ylinJiang/Maze-Breaker/README.md

# Maze-Breaker
Designed and implemented a 3D-printed robot capable of mapping and solving mazes in two phases: sensor-based exploration (left-hand rule) and optimized pathfinding for speed.

## Here is our design.
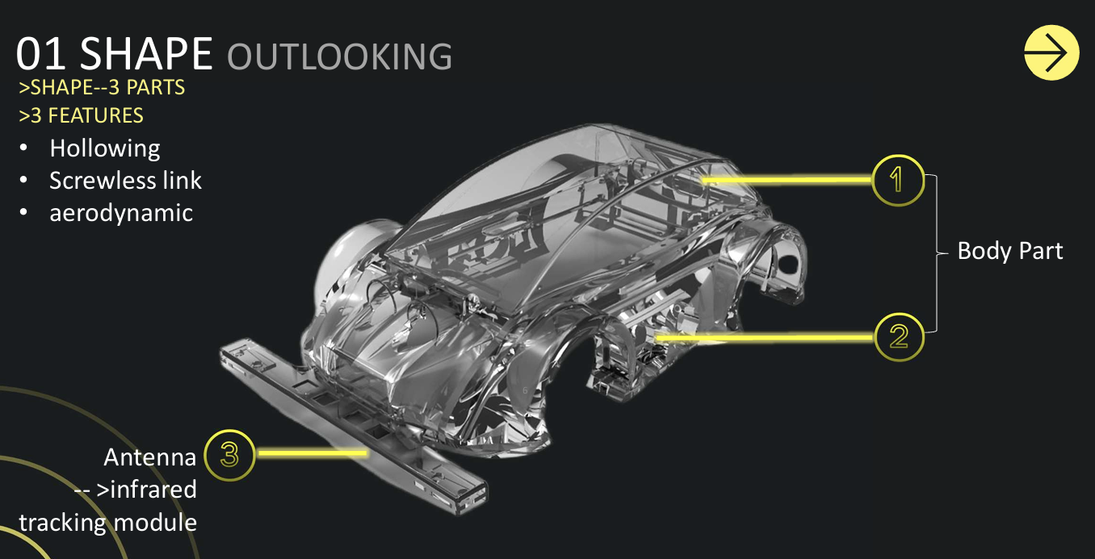
[picture p1: Designed Car.png]
