ylinJiang/Maze-Breaker/Final PPT.pdf

# MAZE-BREAKER Group member 敖恺

- 江柯垚
- 解炎
- 姜跃琳
- 张善
（排名不分先后）

2

2

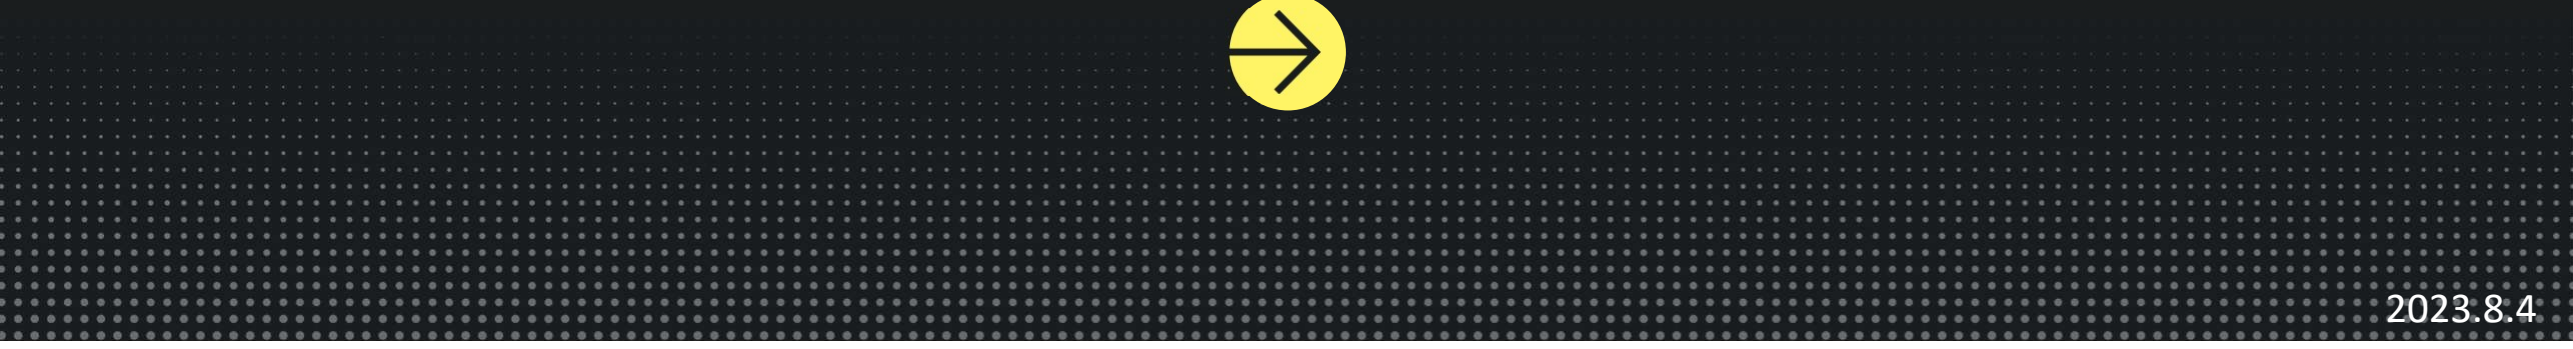
[picture p27: figure]

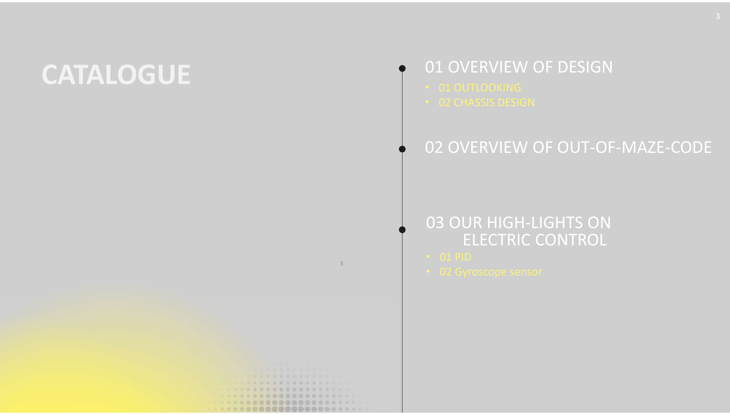
[picture p28: figure]
01 OVERVIEW OF DESIGN; • 01 OUTLOOKING • 02 CHASSIS DESIGN; 02 OVERVIEW OF OUT-OF-MAZE-CODE; 03 OUR HIGH-LIGHTS ON ELECTRIC CONTROL • 01 PID • 02 Gyroscope sensor; CATALOGUE

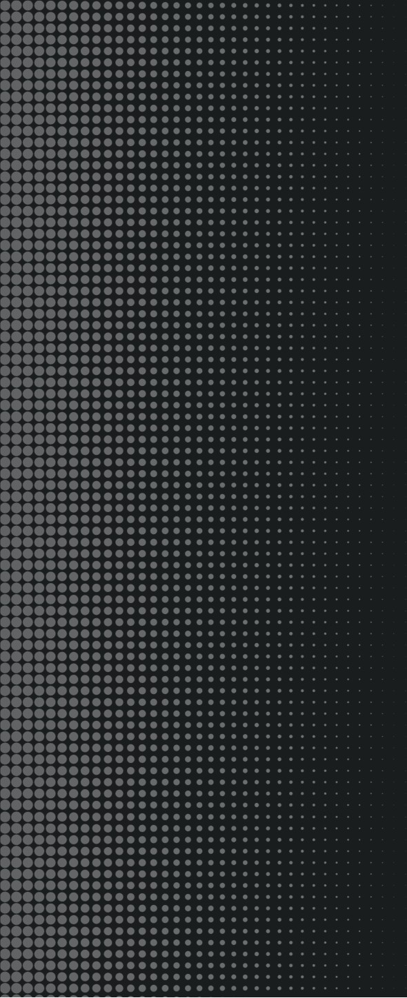
[picture p29: figure]

# 01 OVERVIEW OF DESIGN

### 01 OUTLOOKING

4

4

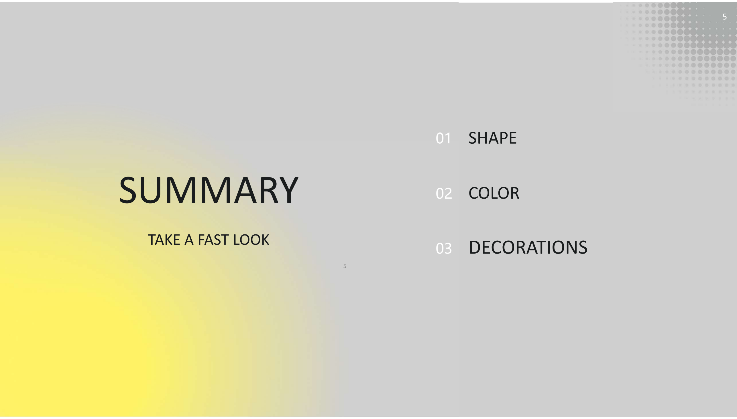
[picture p30: page 4]

# SUMMARY

TAKE A FAST LOOK

### 01 SHAPE

### 02 COLOR

### 03 DECORATIONS

5

5

## 01 SHAPE OUTLOOKING

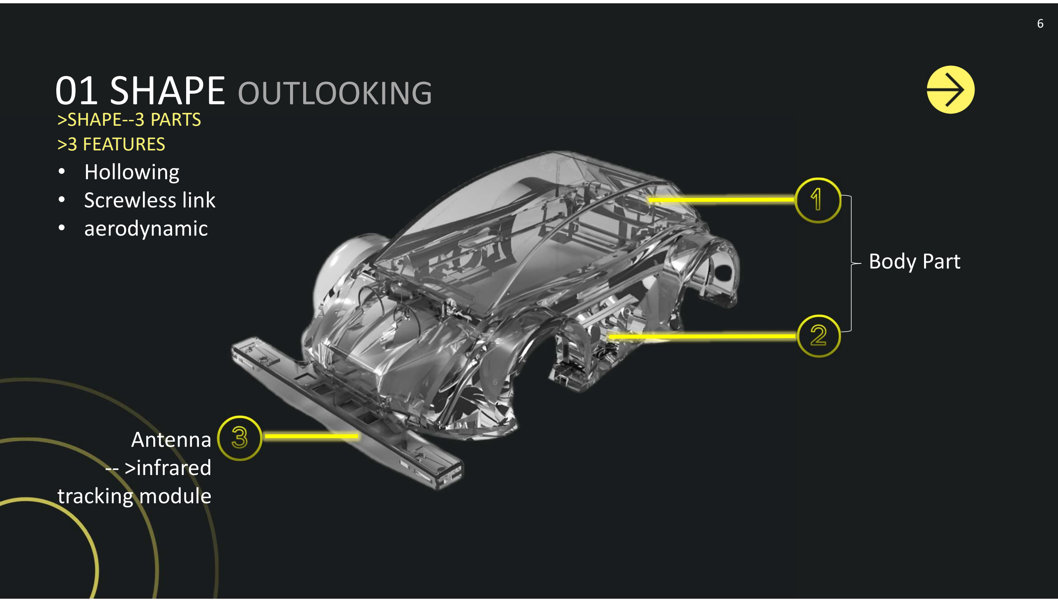
[picture p31: page 5]

>SHAPE--3 PARTS
>3 FEATURES

Body Part

Antenna
-- >infrared
tracking module
- Hollowing
- Screwless link
- aerodynamic

6

6

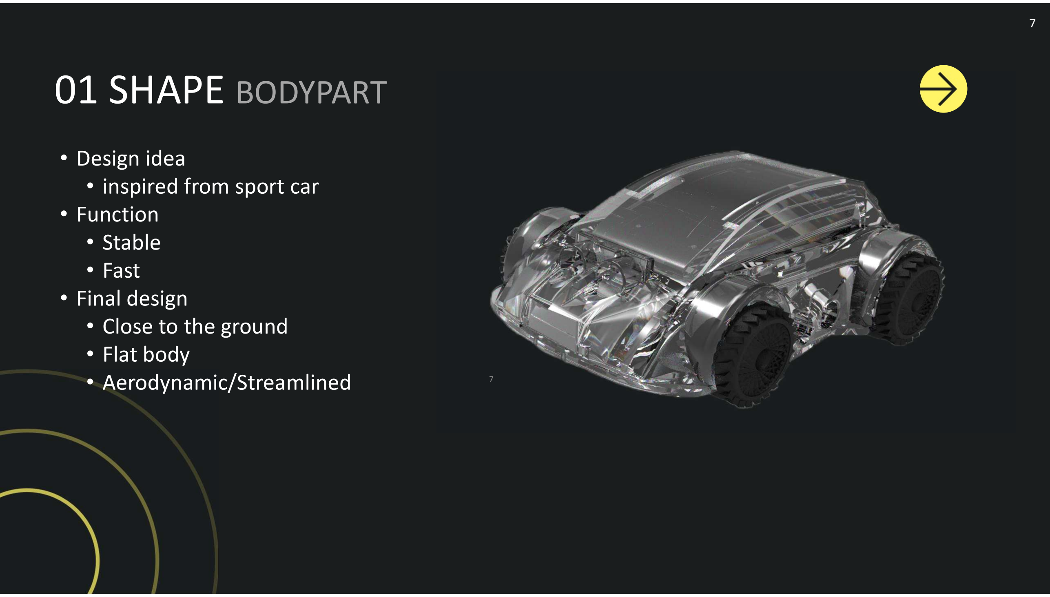
[picture p32: page 6]

01 SHAPE BODYPART • Design idea • inspired from sport car • Function • Stable • Fast • Final design • Close to the ground • Flat body • Aerodynamic/Streamlined | 7 | 7

# 01 SHAPE Antenna

- Function
- Protect the infrared tracking module
- Expand the scope of exploration

8

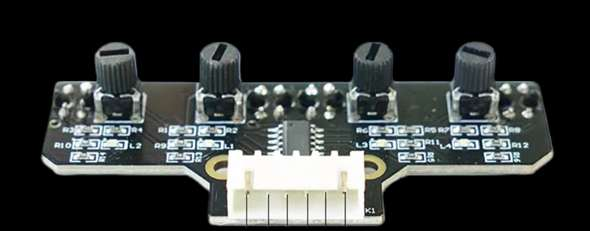
[picture p33: figure]
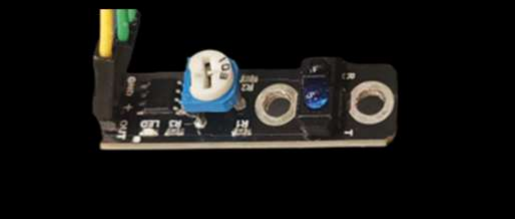
[picture p34: figure]
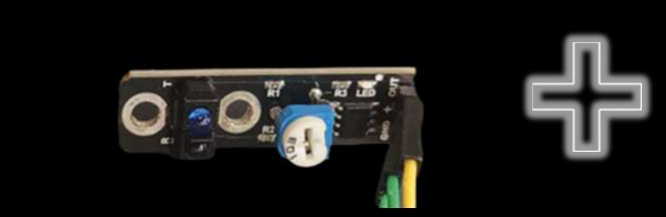
[picture p35: figure]
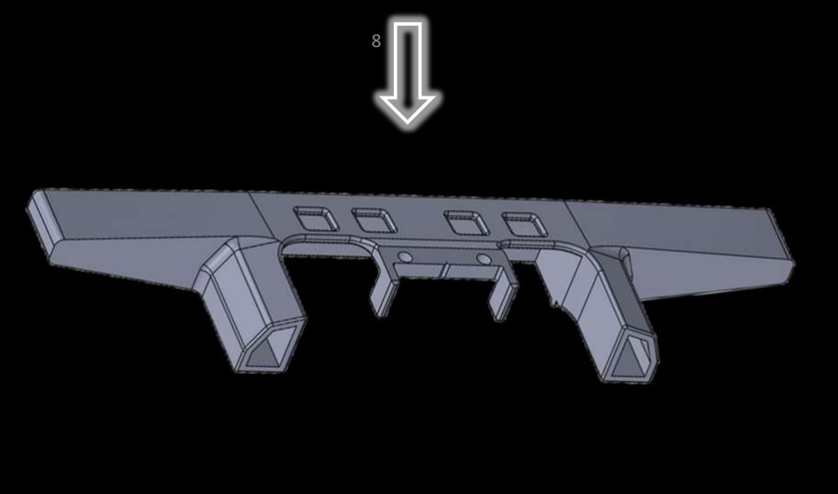
[picture p36: figure]
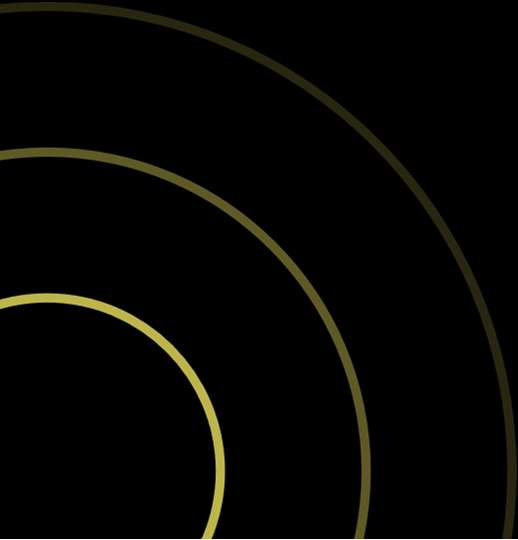
[picture p37: figure]

# 02 COLOR

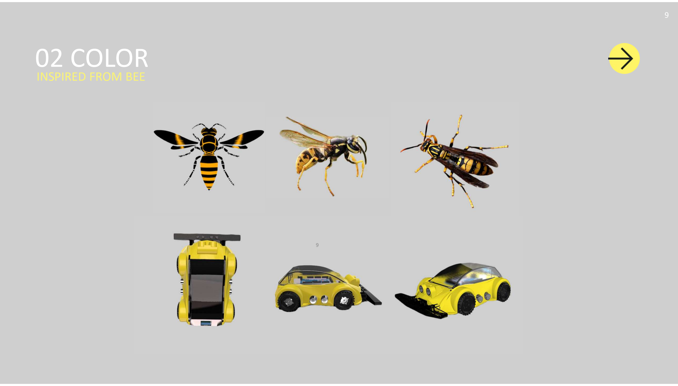
[picture p38: page 8]

INSPIRED FROM BEE

9

9

# 02 DECORATIONS

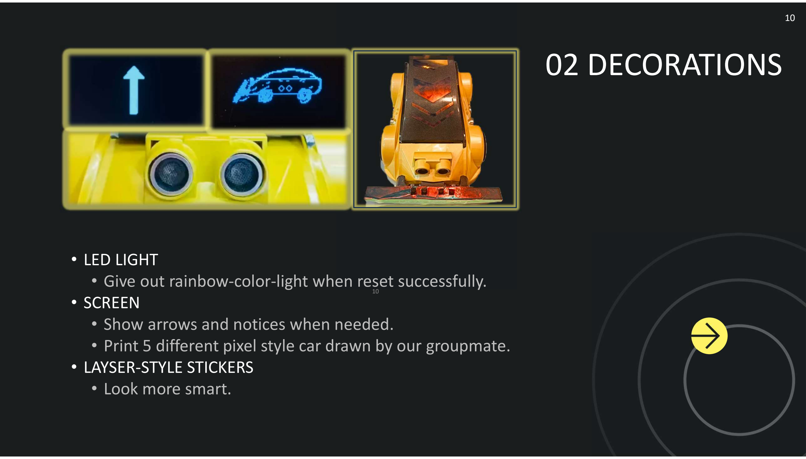
[picture p39: page 9]

- LED LIGHT
- Give out rainbow-color-light when reset successfully.
- SCREEN
- Show arrows and notices when needed.
- Print 5 different pixel style car drawn by our groupmate.
- LAYSER-STYLE STICKERS
- Look more smart.

10

10

# OVER VEIW OF THE WHOLE PRODUCT

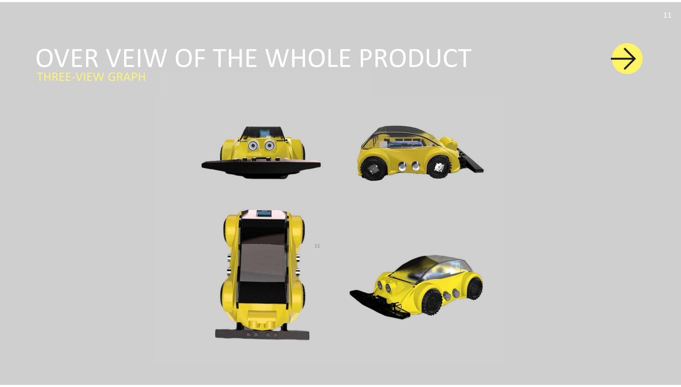
[picture p40: page 10]

THREE-VIEW GRAPH

11

11

# OVER VEIW OF THE WHOLE PRODUCT

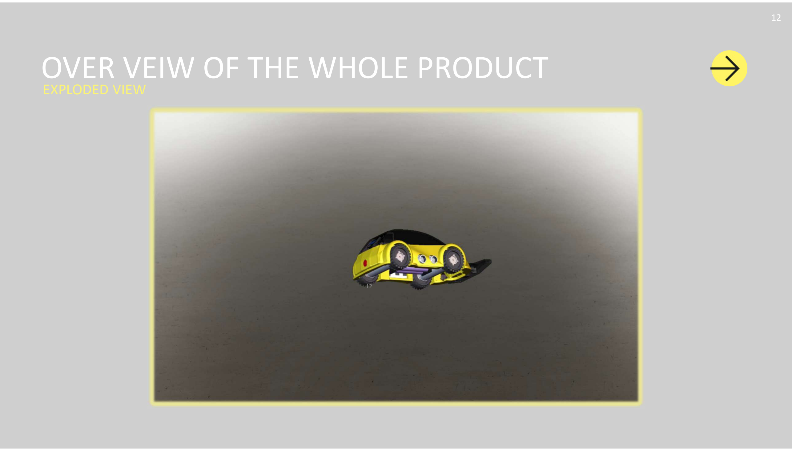
[picture p41: page 11]

EXPLODED VIEW

12

12

# 01 OVERVIEW OF DESIGN

### 02 CHASSIS DESIGN

13

13

# 1 CHASSIS DESIGN

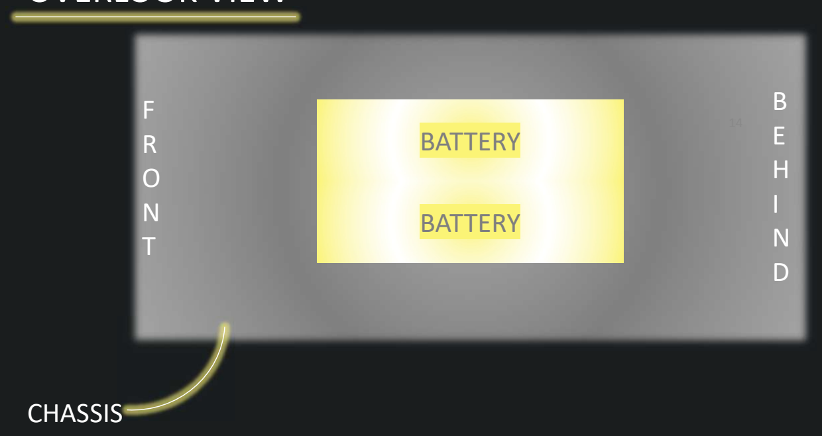
[picture p42: figure]
FRONT; BATTERY; CHASSIS

CHASSIS

SIDE VIEW

OVERLOOK VIEW

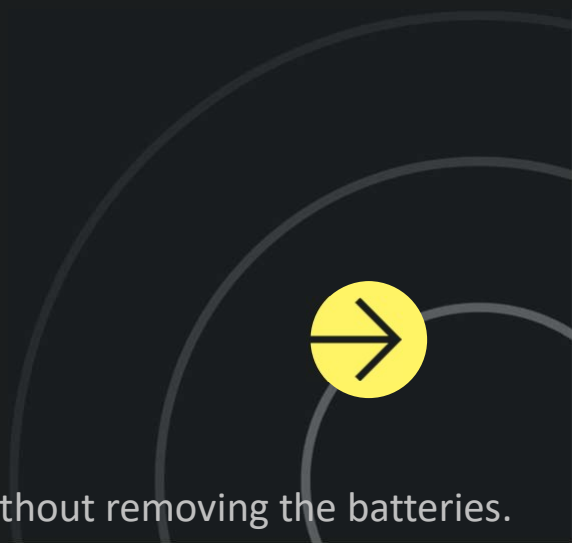
[picture p43: figure]

- The long-side of battery case parallel to the long-side of car --More space left for the
equipment of ultrasonic.
- Leave type-C joggle* on the batter case behind
--Wires connect easier.

type-C joggle*:Used to charge the battery without removing the batteries.

14

# CHASSIS DESIGN

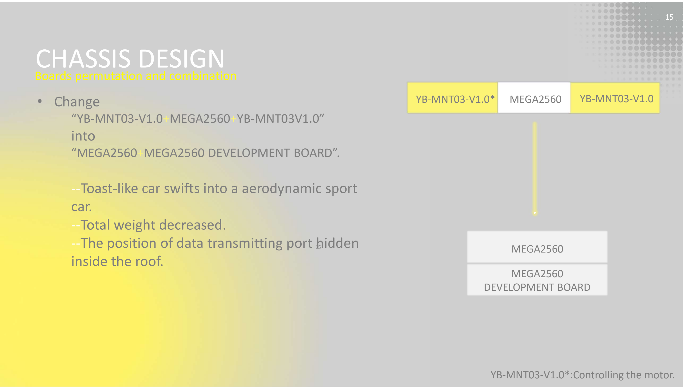
[picture p44: page 14]

- Change
“YB-MNT03-V1.0+MEGA2560+YB-MNT03V1.0” into
“MEGA2560+MEGA2560 DEVELOPMENT BOARD”. --Toast-like car swifts into a aerodynamic sport

car. --Total weight decreased. --The position of data transmitting port hidden

inside the roof.

YB-MNT03-V1.0* MEGA2560 YB-MNT03-V1.0

MEGA2560

MEGA2560
DEVELOPMENT BOARD

YB-MNT03-V1.0*:Controlling the motor.

Boards permutation and combination

15

15

# CHASSIS DESIGN

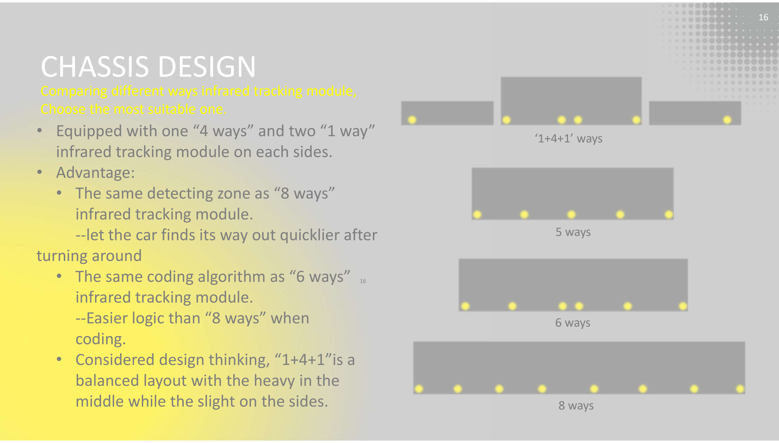
[picture p45: page 15]

- Equipped with one “4 ways” and two “1 way” infrared tracking module on each sides. • Advantage: • The same detecting zone as “8 ways”

infrared tracking module.
--let the car finds its way out quicklier after turning around • The same coding algorithm as “6 ways”

infrared tracking module.
--Easier logic than “8 ways” when
coding. • Considered design thinking, “1+4+1”is a

balanced layout with the heavy in the middle while the slight on the sides.

Comparing different ways infrared tracking module, Choose the most suitable one.

‘1+4+1’ ways

### 5 ways

### 6 ways

### 8 ways

16

16

# OVERVIEW OF OUT-OF-MAZE-CODE

17

17

# OVERAL IDEAS

### 1 EXPLORE THE WAY OUT

Abstract the zero-one-matrix from the trail.

### 2 REMAP THE ZERO-ONE-MATRIX

Delete dead ends.

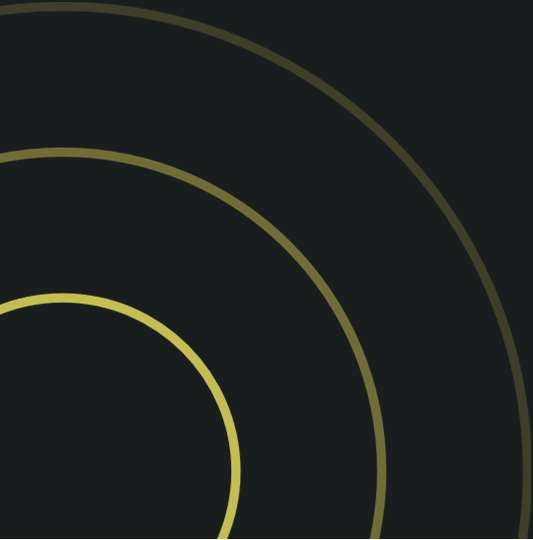
[picture p46: figure]

### 3 GET CORNER’S COORDINATE

Select corner by traversal.

### 4 WALK OUT WITHOUT DEAD ENDS

Use selected corners when needed.

18

18

# 1 EXPLORE THE WAY OUT

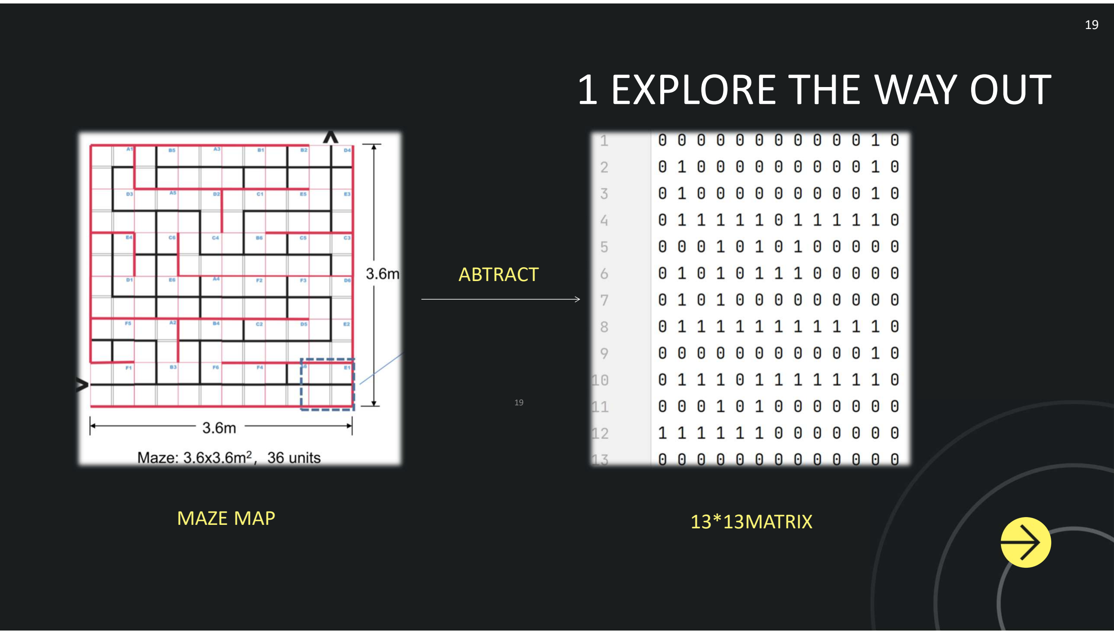
[picture p47: page 18]

ABTRACT

MAZE MAP | 13*13MATRIX

19

19

# 2 REMAP THE ZERO-ONE-MATRIX

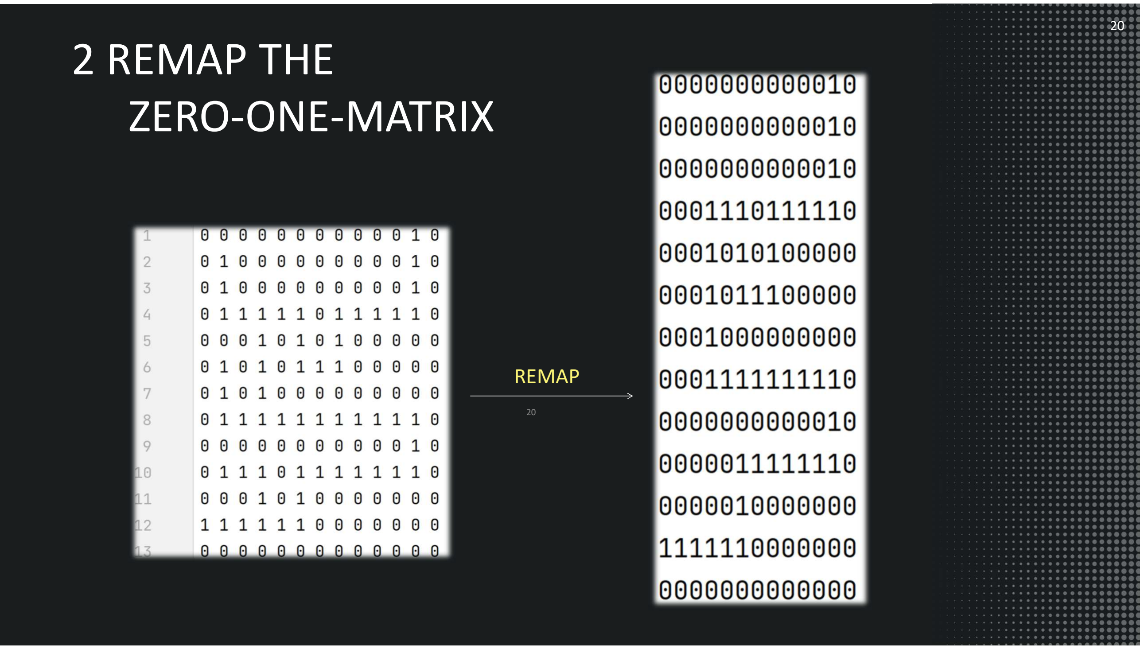
[picture p48: page 19]

REMAP

20

20

# 03 GET CORNER’S COORDINATE

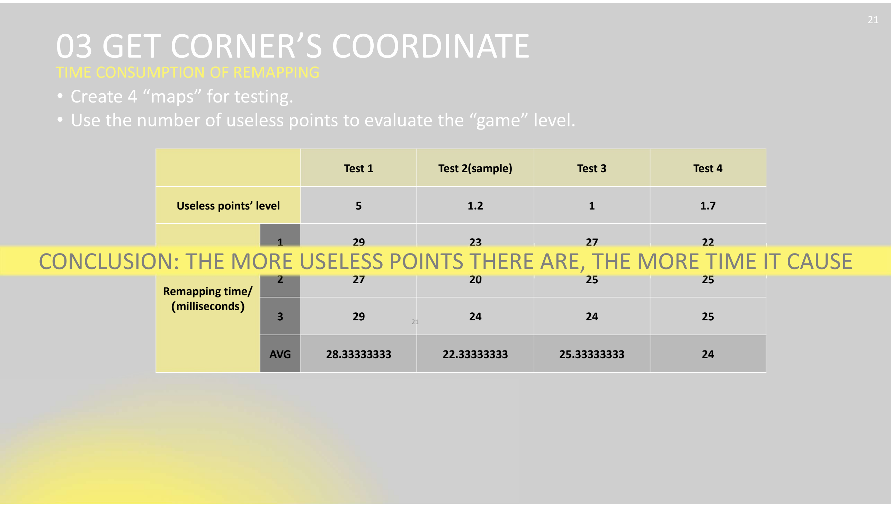
[picture p49: page 20]

TIME CONSUMPTION OF REMAPPING

| Test 1 | Test 2(sample) | Test 3 | Test 4
Useless points’ level | 5 | 1.2 | 1 | 1.7
Remapping time/ （milliseconds） | 1 | 29 | 23 | 27 | 22
| 2 | 27 | 20 | 25 | 25
| 3 | 29 21 | 24 | 24 | 25
| AVG | 28.33333333 | 22.33333333 | 25.33333333 | 24
- Create 4 “maps” for testing.
- Use the number of useless points to evaluate the “game” level.

### CONCLUSION: THE MORE USELESS POINTS THERE ARE, THE MORE TIME IT CAUSE

TIME CONSUMPTION OF REMAPPING

21

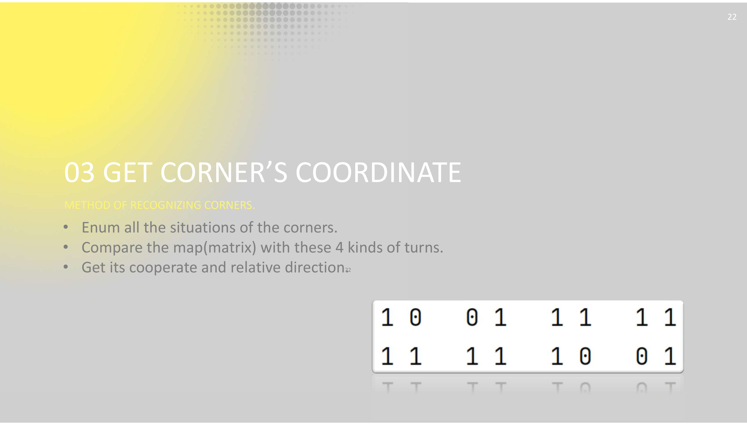
[picture p50: page 21]

METHOD OF RECOGNIZING CORNERS.

# 03 GET CORNER’S COORDINATE

- Enum all the situations of the corners.
- Compare the map(matrix) with these 4 kinds of turns.
- Get its cooperate and relative direction.22

22

# 03 GET CORNER’S COORDINATE

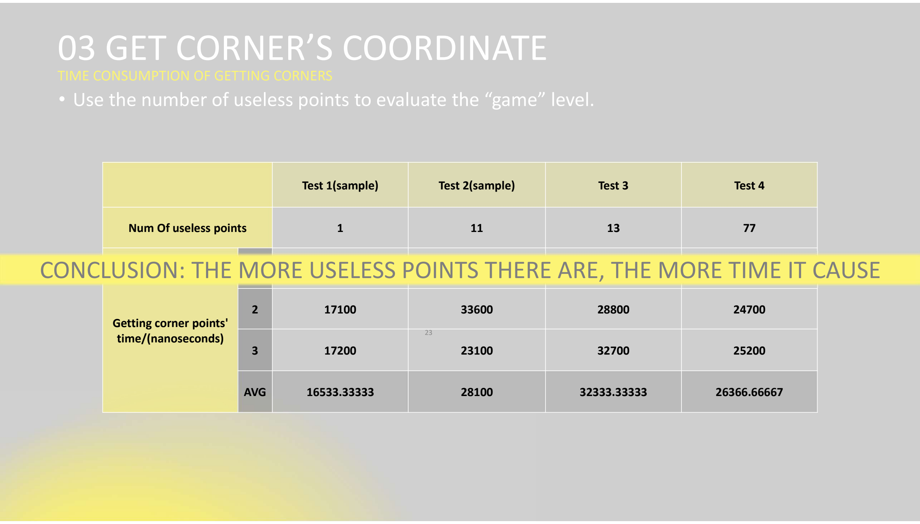
[picture p51: page 22]

| Test 1(sample) | Test 2(sample) | Test 3 | Test 4
Num Of useless points | 1 | 11 | 13 | 77
Getting corner points' time/(nanoseconds) | 1 | 15300 | 27600 | 35500 | 29200
| 2 | 17100 | 33600 | 28800 | 24700
| 3 | 17200 | 23 23100 | 32700 | 25200
| AVG | 16533.33333 | 28100 | 32333.33333 | 26366.66667

TIME CONSUMPTION OF GETTING CORNERS

### CONCLUSION: THE MORE USELESS POINTS THERE ARE, THE MORE TIME IT CAUSE

- Use the number of useless points to evaluate the “game” level.

# 03 WALK OUT WITHOUT DEAD ENDS

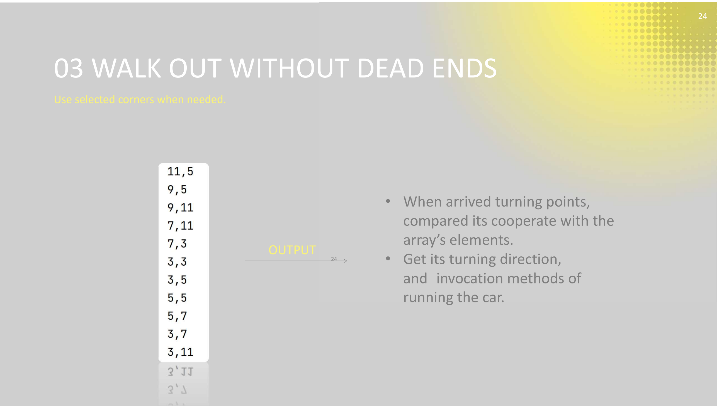
[picture p52: page 23]

Use selected corners when needed.

OUTPUT

- When arrived turning points, compared its cooperate with the array’s elements.
- Get its turning direction,
and invocation methods of
running the car.

24

24

# 03 OUR HIGH-LIGHTS ON

# Electric control

### 01 PID

25

25

# INCREMENT PID

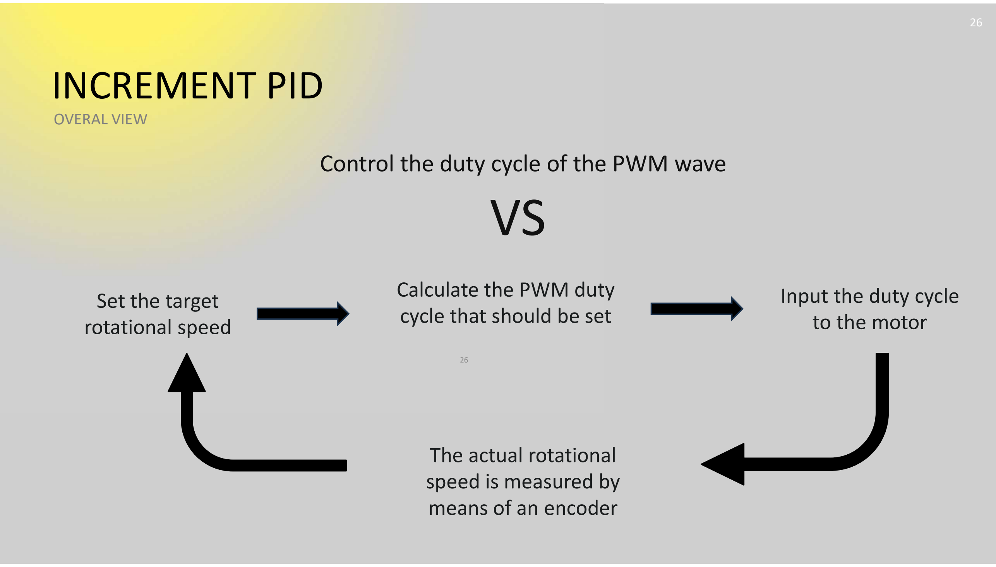
[picture p53: page 25]

Control the duty cycle of the PWM wave

The actual rotational
speed is measured by
means of an encoder

Calculate the PWM duty
cycle that should be set Set the target rotational speed

Input the duty cycle
to the motor

VS

OVERAL VIEW

26

26

# INCREMENT PID

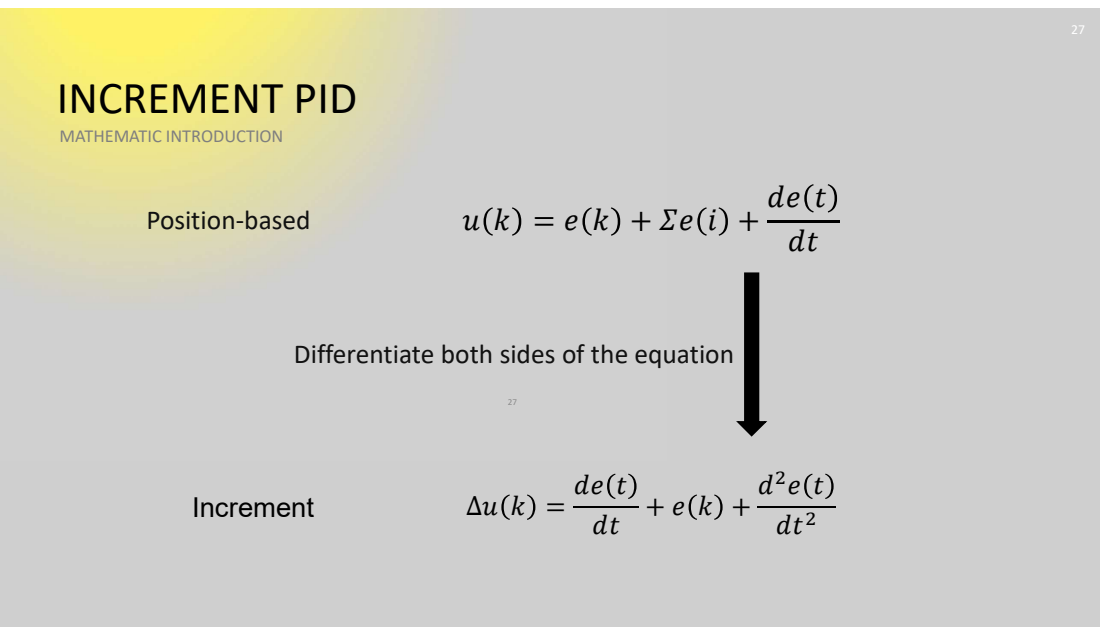
[picture p54: page 26]
Position-based; Increment; MATHEMATIC INTRODUCTION

Differentiate both sides of the equation

# INCREMENT PID

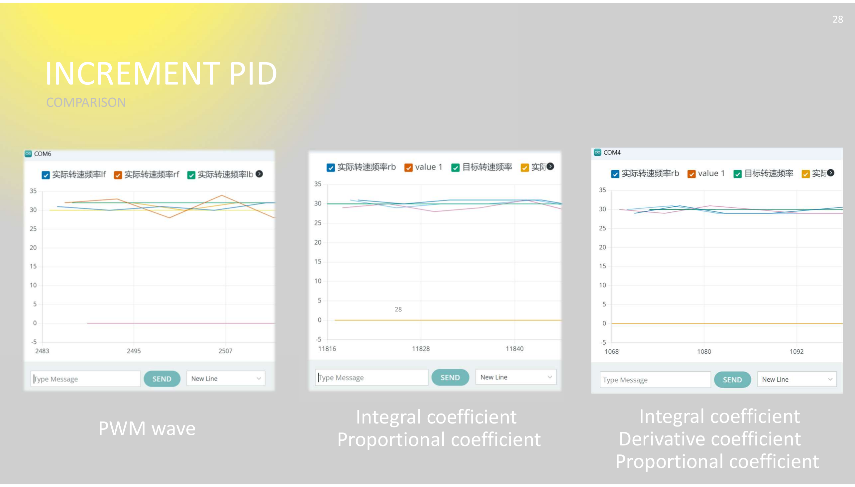
[picture p55: page 27]

COMPARISON

PWM wave | Integral coefficient Proportional coefficient

Integral coefficient
Derivative coefficient
Proportional coefficient

28

28

# INCREMENT PID

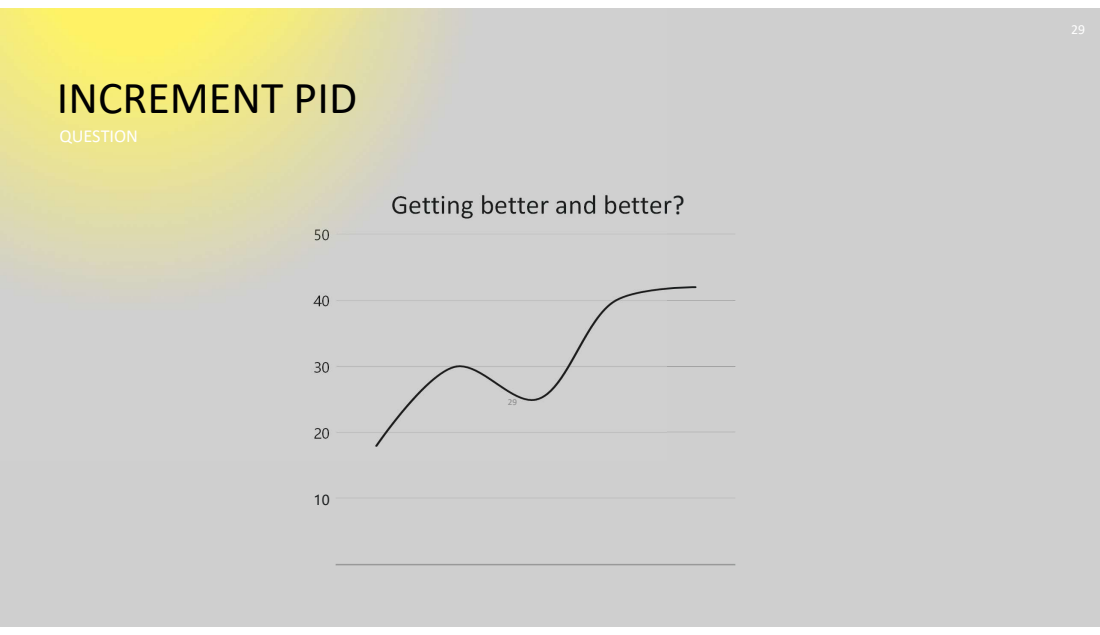
[picture p56: page 28]
QUESTION

Getting better and better?

# PID

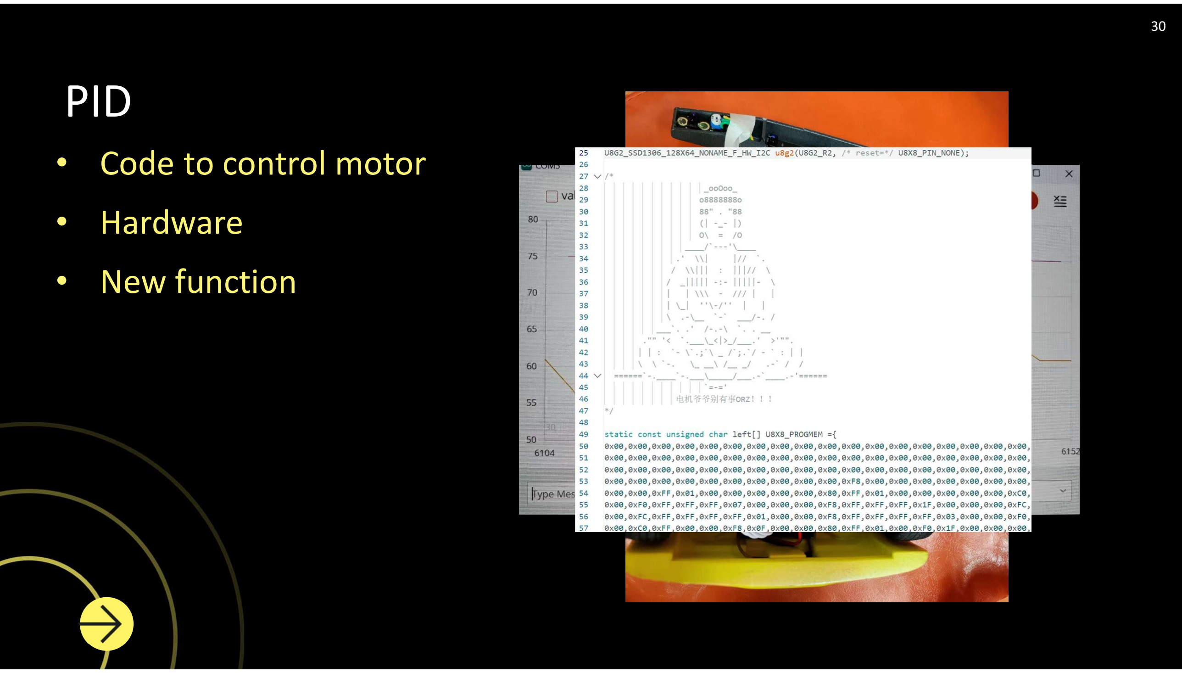
[picture p57: page 29]

## - Code to control motor - Hardware - New function

30

30

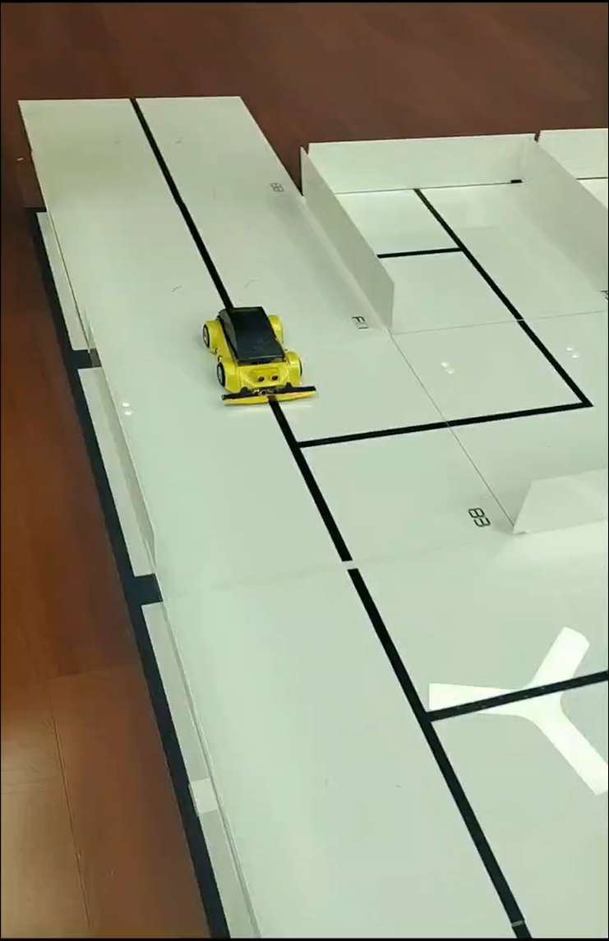
[picture p58: figure]

## - The infrared tracking module - Out –loop control

## - PID - Inner-loop control

# Electric control

31

31

# 03 OUR HIGH-LIGHTS ON

# Electric control

### 02 Gyroscope sensor MPU6050

32

32

# 03 GROSCOPE SENSOR MPU6050

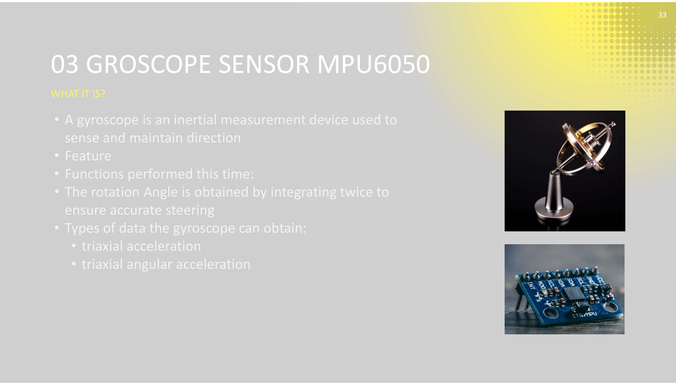
[picture p59: page 32]

WHAT IT IS?

33

- A gyroscope is an inertial measurement device used to sense and maintain direction
- Feature
- Functions performed this time:
- The rotation Angle is obtained by integrating twice to ensure accurate steering
- Types of data the gyroscope can obtain:
- triaxial acceleration
- triaxial angular acceleration

# 03 GROSCOPE SENSOR MPU6050

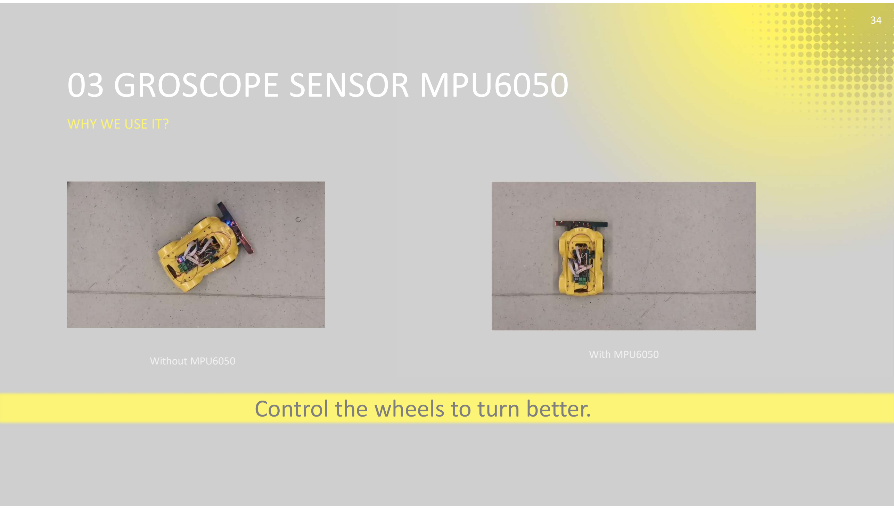
[picture p60: page 33]

WHY WE USE IT?

34

Control the wheels to turn better.

Without MPU6050 | With MPU6050

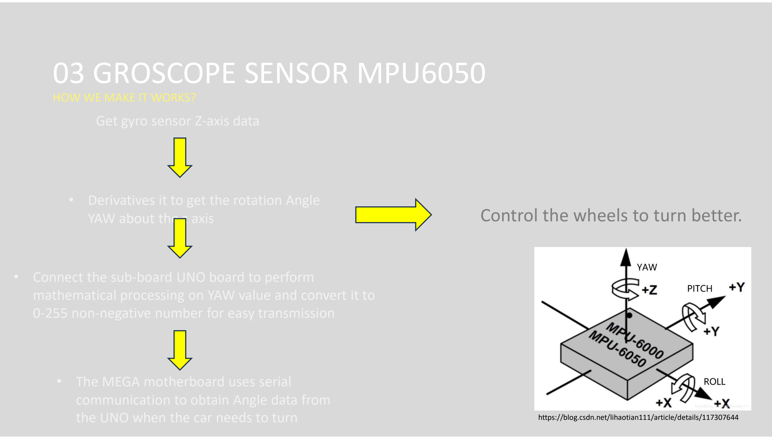
[picture p61: figure]
Get gyro sensor Z-axis data; https://blog.csdn.net/lihaotian111/article/details/117307644; YAW about the z axis; • The MEGA motherboard uses serial communication to obtain Angle data from the UNO when the car needs to turn; Control the wheels to turn better.; 03 GROSCOPE SENSOR MPU6050; HOW WE MAKE IT WORKS?

- Derivatives it to get the rotation Angle
- Connect the sub-board UNO board to perform mathematical processing on YAW value and convert it to 0-255 non-negative number for easy transmission

# 03 GROSCOPE SENSOR MPU6050

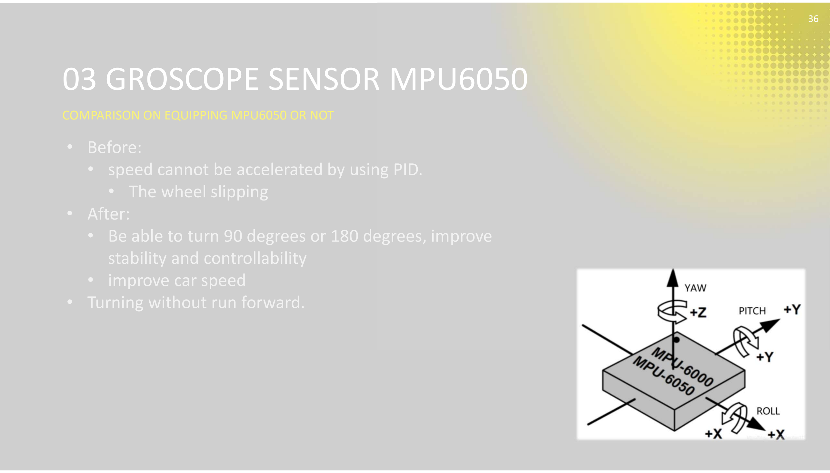
[picture p62: page 35]

COMPARISON ON EQUIPPING MPU6050 OR NOT

36

- Before:
- speed cannot be accelerated by using PID.
- The wheel slipping
- After:
- Be able to turn 90 degrees or 180 degrees, improve stability and controllability
- improve car speed
- Turning without run forward.

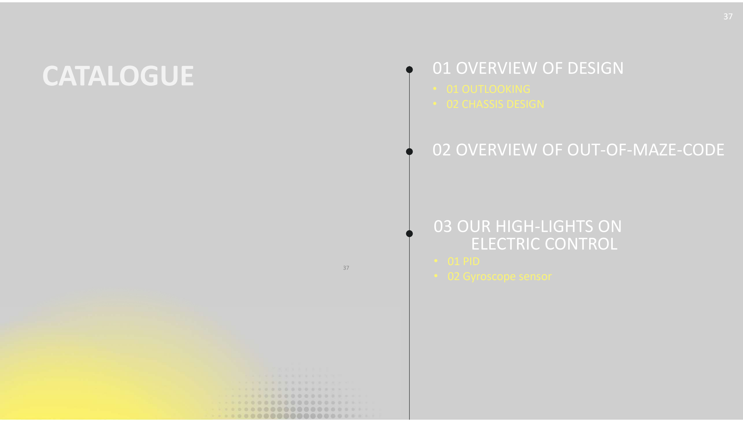
[picture p63: figure]
CATALOGUE; 01 OVERVIEW OF DESIGN; • 01 OUTLOOKING • 02 CHASSIS DESIGN; 02 OVERVIEW OF OUT-OF-MAZE-CODE; 03 OUR HIGH-LIGHTS ON ELECTRIC CONTROL • 01 PID • 02 Gyroscope sensor

# THANKS FOR LISTENING

38

38
