ylinJiang/Maze-Breaker/car_modeling_files/Part1_Cover.SLDPRT

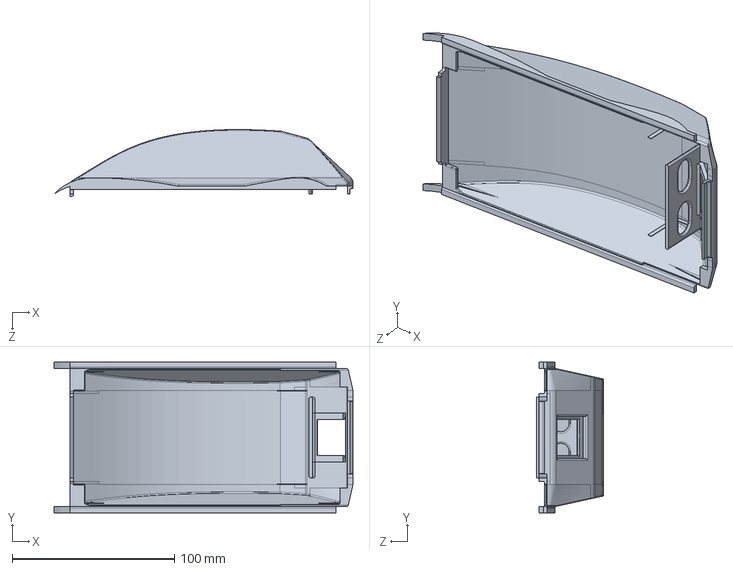
[picture p64: CAD file, 2025-04-10]
car_modeling_files/Part1_Cover.SLDPRT
184.5 x 93.0 x 41.3 mm
