ylinJiang/Maze-Breaker/car_modeling_files/Part3_Front.SLDPRT

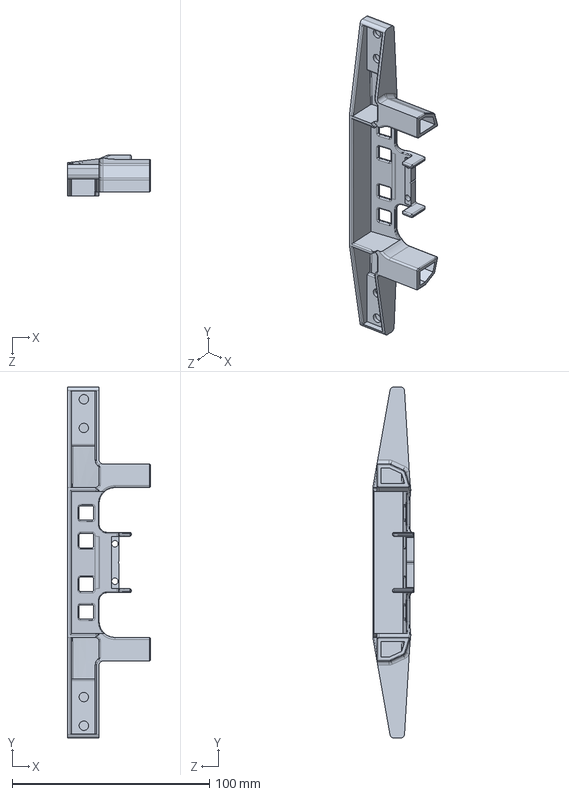
[picture p65: CAD file, 2025-04-10]
car_modeling_files/Part3_Front.SLDPRT
42.0 x 178.0 x 21.0 mm
