ylinJiang/Maze-Breaker/arduino_code/ssd1306/ssd1306.ino

#include <Arduino.h>
#include <U8g2lib.h>

#ifdef U8X8_HAVE_HW_SPI
#include <SPI.h>
#endif
#ifdef U8X8_HAVE_HW_I2C
#include <Wire.h>
#endif

/*
  U8g2lib Example Overview:
    Frame Buffer Examples: clearBuffer/sendBuffer. Fast, but may not work with all Arduino boards because of RAM consumption
    Page Buffer Examples: firstPage/nextPage. Less RAM usage, should work with all Arduino boards.
    U8x8 Text Only Example: No RAM usage, direct communication with display controller. No graphics, 8x8 Text only.
    
  This is a frame buffer example.    
*/

// Please UNCOMMENT one of the contructor lines below
// U8g2 Contructor List (Frame Buffer)
// The complete list is available here: https://github.com/olikraus/u8g2/wiki/u8g2setupcpp
// Please update the pin numbers according to your setup. Use U8X8_PIN_NONE if the reset pin is not connected
//U8G2_NULL u8g2(U8G2_R0);	// null device, a 8x8 pixel display which does nothing
//U8G2_SSD1306_128X64_NONAME_F_4W_SW_SPI u8g2(U8G2_R0, /* clock=*/ 13, /* data=*/ 11, /* cs=*/ 10, /* dc=*/ 9, /* reset=*/ 8);
//U8G2_SSD1306_128X64_NONAME_F_4W_HW_SPI u8g2(U8G2_R0, /* cs=*/ 12, /* dc=*/ 4, /* reset=*/ 6);	// Arduboy (Production, Kickstarter Edition)
//U8G2_SSD1306_128X64_NONAME_F_4W_HW_SPI u8g2(U8G2_R0, /* cs=*/ 10, /* dc=*/ 9, /* reset=*/ 8);
//U8G2_SSD1306_128X64_NONAME_F_3W_SW_SPI u8g2(U8G2_R0, /* clock=*/ 13, /* data=*/ 11, /* cs=*/ 10, /* reset=*/ 8);
//U8G2_SSD1306_128X64_NONAME_F_3W_HW_SPI u8g2(U8G2_R0, /* cs=*/ 10, /* reset=*/ 8);
U8G2_SSD1306_128X64_NONAME_F_HW_I2C u8g2(U8G2_R2, /* reset=*/ U8X8_PIN_NONE);
//U8G2_SSD1306_128X64_ALT0_F_HW_I2C u8g2(U8G2_R0, /* reset=*/ U8X8_PIN_NONE);   // same as the NONAME variant, but may solve the "every 2nd line skipped" problem
//U8G2_SSD1306_128X64_NONAME_F_SW_I2C u8g2(U8G2_R0, /* clock=*/ 13, /* data=*/ 11, /* reset=*/ 8);
//U8G2_SSD1306_128X64_NONAME_F_SW_I2C u8g2(U8G2_R0, /* clock=*/ SCL, /* data=*/ SDA, /* reset=*/ U8X8_PIN_NONE);   // All Boards without Reset of the Display
//U8G2_SSD1306_128X64_NONAME_F_SW_I2C u8g2(U8G2_R0, /* clock=*/ 16, /* data=*/ 17, /* reset=*/ U8X8_PIN_NONE);   // ESP32 Thing, pure SW emulated I2C
//U8G2_SSD1306_128X64_NONAME_F_HW_I2C u8g2(U8G2_R0, /* reset=*/ U8X8_PIN_NONE, /* clock=*/ 16, /* data=*/ 17);   // ESP32 Thing, HW I2C with pin remapping
//U8G2_SSD1306_128X64_NONAME_F_6800 u8g2(U8G2_R0, 13, 11, 2, 3, 4, 5, 6, A4, /*enable=*/ 7, /*cs=*/ 10, /*dc=*/ 9, /*reset=*/ 8);
//U8G2_SSD1306_128X64_NONAME_F_8080 u8g2(U8G2_R0, 13, 11, 2, 3, 4, 5, 6, A4, /*enable=*/ 7, /*cs=*/ 10, /*dc=*/ 9, /*reset=*/ 8);
//U8G2_SSD1306_128X64_VCOMH0_F_4W_HW_SPI u8g2(U8G2_R0, /* cs=*/ 10, /* dc=*/ 9, /* reset=*/ 8);	// same as the NONAME variant, but maximizes setContrast() range
//U8G2_SSD1306_128X64_ALT0_F_4W_HW_SPI u8g2(U8G2_R0, /* cs=*/ 10, /* dc=*/ 9, /* reset=*/ 8);	// same as the NONAME variant, but may solve the "every 2nd line skipped" problem

// U8G2_SSD1306_128X64_NONAME_F_SW_I2C u8g2(U8G2_R0, /* clock=*/ A5, /* data=*/ A4, /* reset=*/ U8X8_PIN_NONE);

// End of constructor list

//#define MINI_LOGO

static const unsigned char cat[] U8X8_PROGMEM = {
0x00,0x00,0x00,0x00,0x00,0x00,0x00,0x00,0x00,0x00,0x00,0x00,0x00,0x00,0x00,0x00,0x00,0x00,0x00,0x00,0x00,0x00,0x00,0x00,0x00,0x00,0x00,0x00,0x00,0x00,0x00,0x00,
0x00,0x00,0x00,0x00,0x00,0x00,0x00,0x00,0x00,0x00,0x00,0x00,0x00,0x00,0x00,0x00,0x00,0x00,0x00,0x00,0x00,0x00,0x00,0x00,0x00,0x00,0x00,0x00,0x00,0x00,0x00,0x00,
0x00,0x00,0x00,0x00,0x00,0x00,0x00,0x00,0x00,0x00,0x00,0x00,0x00,0x00,0x00,0x00,0x00,0x20,0x00,0x00,0x00,0x00,0x00,0x00,0x00,0xD0,0x00,0x00,0x00,0x00,0x0F,0x00,
0x00,0x90,0x07,0x00,0x00,0xC0,0x08,0x00,0x00,0x08,0x0F,0x00,0x00,0x70,0x10,0x00,0x00,0x08,0x1E,0x00,0x00,0x38,0x10,0x00,0x00,0x08,0x7D,0x00,0x00,0x1E,0x10,0x00,
0x00,0x08,0xFA,0x00,0x00,0x0F,0x30,0x00,0x00,0x04,0xF4,0x03,0xC0,0x07,0x20,0x00,0x00,0x04,0xE8,0x07,0xE0,0x13,0x30,0x00,0x00,0x04,0xFA,0xFF,0xFF,0x0B,0x20,0x00,
0x00,0x44,0xD4,0xFF,0xFF,0x27,0x20,0x00,0x00,0x84,0xE8,0xFF,0xFF,0x9F,0x30,0x00,0x00,0x04,0xF1,0xFF,0xFF,0x5F,0x30,0x00,0x00,0x04,0xFA,0x3F,0xFE,0x3F,0x10,0x00,
0x00,0x80,0xFC,0x1F,0xFC,0x7F,0x10,0x00,0x00,0x08,0xFE,0x0F,0xF8,0x7F,0x10,0x00,0x00,0x08,0xFF,0x07,0xF0,0xFF,0x10,0x00,0x00,0x88,0xFF,0x03,0xE0,0xFF,0x11,0x00,
0x00,0x88,0x0F,0x03,0xE0,0xF0,0x09,0x00,0x00,0xD0,0x03,0x00,0x00,0xC0,0x0B,0x00,0x00,0xD0,0x01,0x00,0x00,0x80,0x07,0x00,0x00,0xE0,0xE1,0x09,0x80,0x07,0x07,0x00,
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
  
  u8g2.clearBuffer();
  u8g2.drawXBMP(16,0,96,64,car1);
  u8g2.sendBuffer();
  delay(1000);

  u8g2.clearBuffer();
  u8g2.drawXBMP(0,0,128,64,car2);
  u8g2.sendBuffer();
  delay(1000);

  u8g2.clearBuffer();
  u8g2.drawXBMP(0,0,128,64,car3);
  u8g2.sendBuffer();
  delay(1000);

  u8g2.clearBuffer();
  u8g2.drawXBMP(0,0,128,64,car4);
  u8g2.sendBuffer();
  delay(1000);

  u8g2.clearBuffer();
  u8g2.drawXBMP(0,0,128,64,car5);
  u8g2.sendBuffer();
  delay(1000);

  
  // u8g2.clearBuffer();
  // u8g2.drawXBMP(32,0, 64,64,up);
  // u8g2.sendBuffer();
  // delay(1000);

  // u8g2.clearBuffer();
  // u8g2.setFont(u8g2_font_cu12_tr);		  
  // u8g2.setCursor(0,20);
  // u8g2.print("Mission");
  // u8g2.setCursor(0,40);
  // u8g2.print("Accomplished");
  // u8g2.setCursor(0,60);
  // u8g2.print("Happy!");
  // u8g2.setFont(u8g2_font_open_iconic_weather_4x_t);		  
  // u8g2.drawGlyph(90,50,0x0045);
  // u8g2.sendBuffer();
  // delay(1000);

  // u8g2.clearBuffer();
  // u8g2.setFont(u8g2_font_cu12_tr);		  
  // u8g2.setCursor(45,20);
  // u8g2.print("Please");
  // u8g2.setCursor(40,40);
  // u8g2.print("Release");
  // u8g2.setCursor(25,60);
  // u8g2.print("the Button");
  // u8g2.sendBuffer();
  // delay(1000);

  // u8g2.clearBuffer();
  // u8g2.setFont(u8g2_font_open_iconic_weather_4x_t);		  
  // u8g2.drawGlyph(60,50,0x0045);
  // u8g2.sendBuffer();

  // delay(1000);

}
